patback66/sdvx/README.md

# sdvx
DIY Sound Voltex style controller
