patback66/sdvx/docs/index.md

---
layout: default
---

# Welcome

Welcome to the Custom Arcade Controller tutorial! This tutorial is intended for the construction
of a controller for [Sound Voltex](https://en.wikipedia.org/wiki/Sound_Voltex), but the
fundamentals will be applicable for any custom arcade controller.

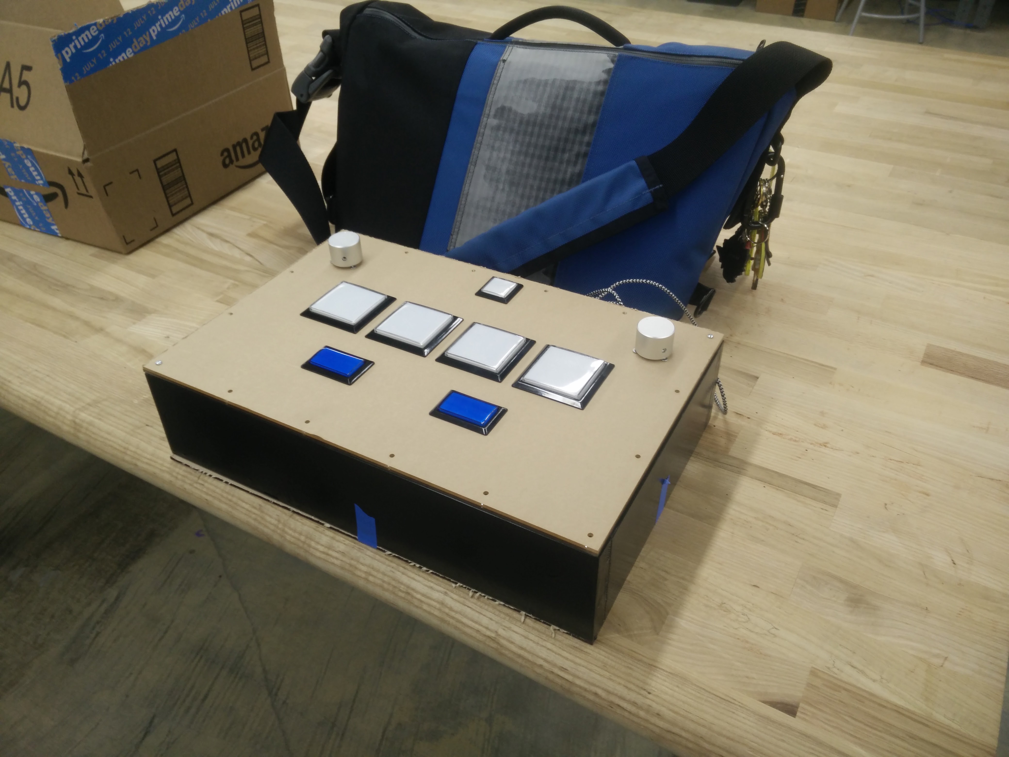
[picture p5: docs/assets/img/IMG_20160810_204727.jpg]
Sample Controller


## Sound Voltex

[Sound Voltex](https://en.wikipedia.org/wiki/Sound_Voltex) is a rhytmn game with
a unique controller. For home play, it may be difficult or expensive to acquire a
controller. For the more technically inclined, building a custom controller may
controller may be the best option.

## Where to Start

The three main sections of this website are:

- [Design](design/) - coming up with what the controller will look like
- [Manufacturing](manufacturing/) - how to build the controller
- [Programming](programming/) - how to program and wire the controller

[comment]: <> (128 Words)
[comment]: <> (Total Word Count: ~5139)
