patback66/sdvx/docs/_pages/references.md

---
layout: page
title: The Plates
permalink: /references/
subtitle: Cutting the Plates
---
1. Aquino, Royce. "SDVX Controller Log 1 | SunKoiWish." Sunkoiwish. May 6, 2016. Accessed October 19, 2016. [http://sunkoiwish.com/story/55-projects/200-sdvx-controller-log-1](http://sunkoiwish.com/story/55-projects/200-sdvx-controller-log-1).
2. Chao, Jess. "Day Wot - The Thought Bubble." SDVX Controller. October 6, 2014. Accessed October 19, 2016. [https://sdvxcontroller.blogspot.com/2014/10/day-wot-thought-bubble.html](https://sdvxcontroller.blogspot.com/2014/10/day-wot-thought-bubble.html).
3. Chao, Jess. "Day Chuu - The Shopping List." SDVX Controller. October 6, 2014. Accessed October 19, 2016. [ https://sdvxcontroller.blogspot.com/2014/10/day-chuu-shopping-list.htm](https://sdvxcontroller.blogspot.com/2014/10/day-chuu-shopping-list.html).
4. Mon. "$70 SDVX Controller." Just Mon Things. July 22, 2016. Accessed October 19, 2016. [http://blog.mon.im/2016/07/70-sdvx-controller.html](http://blog.mon.im/2016/07/70-sdvx-controller.html).
5. Pasquale Buonocunto, Alessandro Biondi, Marco Pagani, Mauro Marinoni, and Giorgio Buttazzo. 2016. “ARTE: arduino real-time extension for programming multitasking applications.” In 	Proceedings of the 31st Annual ACM Symposium on Applied Computing (SAC '16). ACM, New York, NY, USA, 1724-1731.
6. "SDVX Leonardo Tutorial." March 15, 2016. Accessed October 19, 2016. [http://sdvxii.pancakeapps.com/](http://sdvxii.pancakeapps.com/).
7. Sergio Sáez, Jorge Real, and Alfons Crespo. 2012. “An integrated framework for multiprocessor, multimoded real-time applications.” In Proceedings of the 17th Ada-Europe international conference on Reliable Software Technologies (Ada-Europe'12), Mats Brorsson and Luís 	Miguel Pinho (Eds.). Springer-Verlag, Berlin, Heidelberg, 18-34.
