patback66/sdvx/cad/OldVersions/sdvx_top.pdf

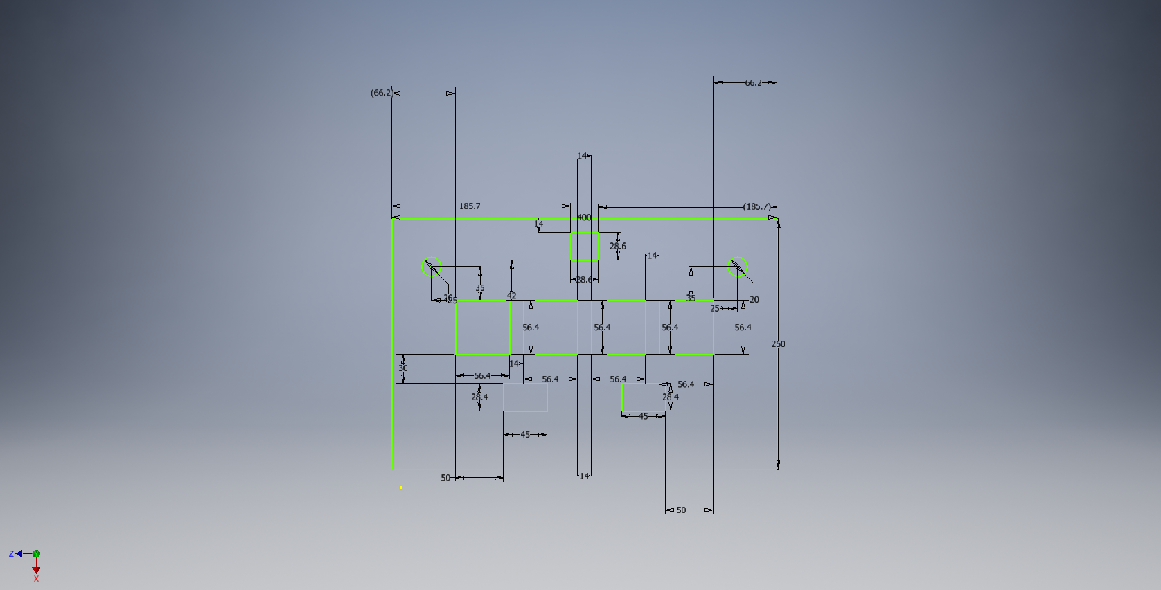
[picture p13: page 1]
