patback66/sdvx/docs/assets/img/10 1 16 11 44 Office Lens.jpg

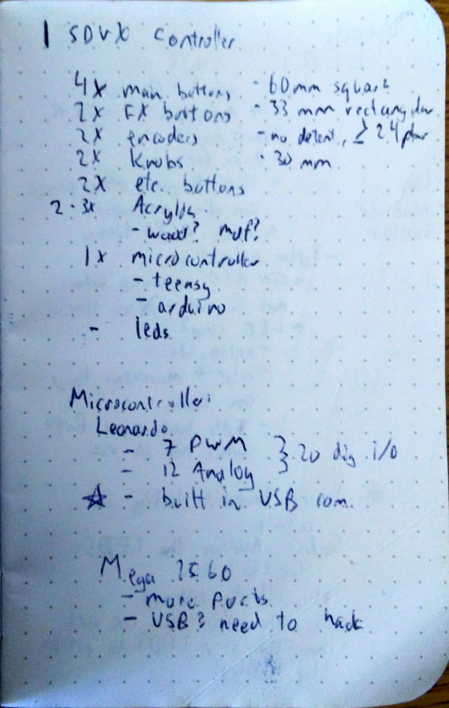
docs/assets/img/10 1 16 11 44 Office Lens.jpg
