patback66/sdvx/docs/assets/img/10 1 16 11 45 Office Lens 1.jpg

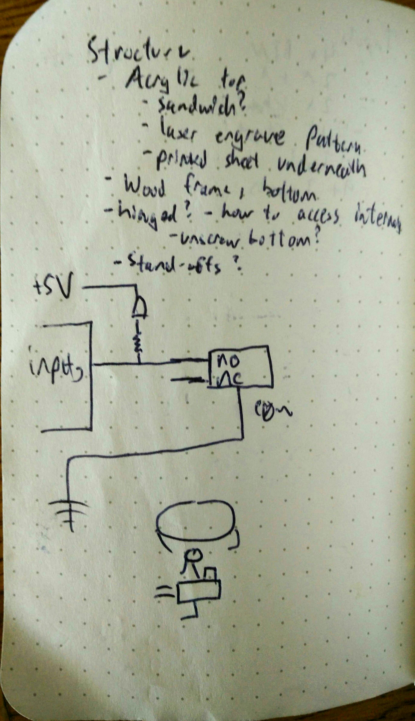
docs/assets/img/10 1 16 11 45 Office Lens 1.jpg
