patback66/sdvx/docs/assets/img/IMG_20160803_185213.jpg

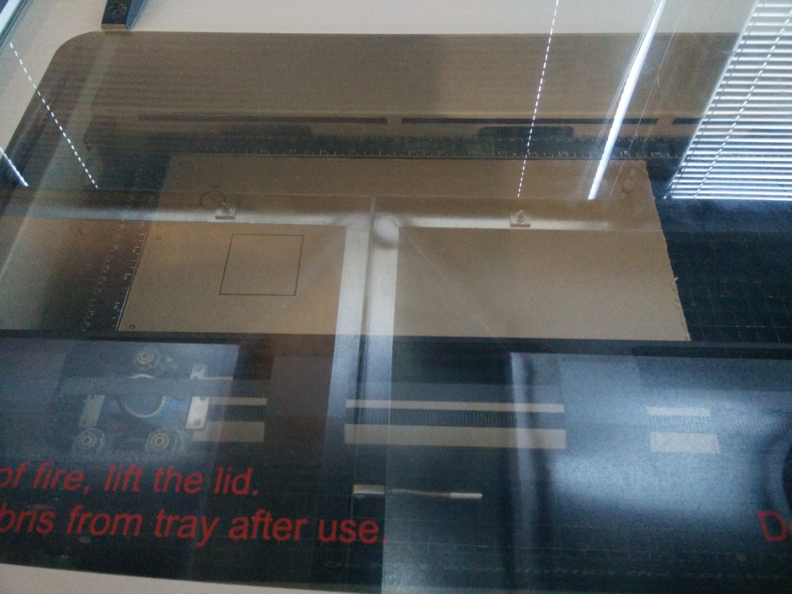
docs/assets/img/IMG_20160803_185213.jpg
