patback66/sdvx/docs/assets/img/IMG_20160803_185450.jpg

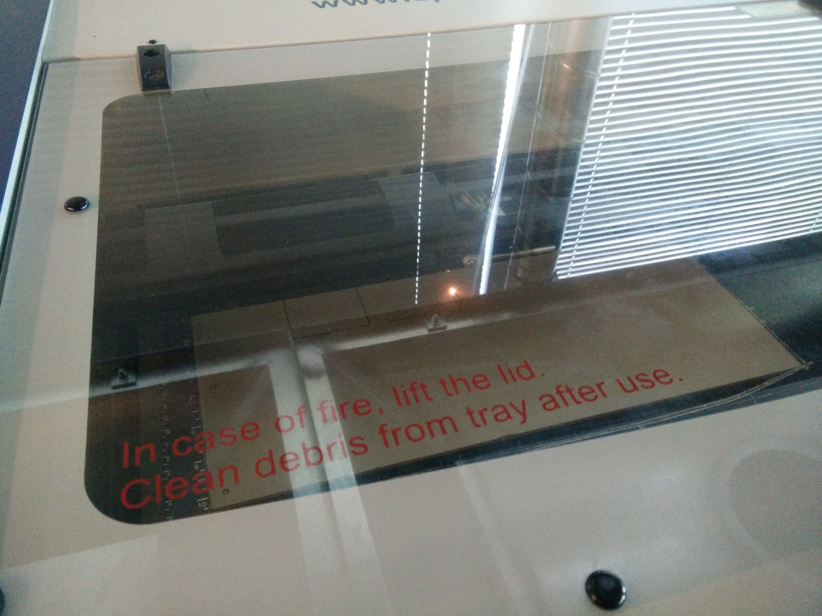
docs/assets/img/IMG_20160803_185450.jpg
