patback66/sdvx/(list of files, cad)

Other CAD files:
cad/sdvx_bottom_check.dwg
cad/sdvx_middle.dwg
cad/sdvx_top_check.dwg
cad/sdvx_bottom.dwg
cad/sdvx_top.dwg
cad/sdvx_middle_check.dwg
cad/OldVersions/sdvx_middle.0001.dwg
cad/OldVersions/sdvx_bottom.0001.ipt
cad/OldVersions/sdvx_middle.0001.ipt
cad/OldVersions/sdvx_top.0005.ipt
cad/sdvx_bottom.ipt
cad/sdvx_middle.ipt
cad/sdvx_top.ipt
