patback66/sdvx/(commit log)

2016-11-05 Switched to jekyll with jackal template
2016-11-18 more wip updates to landing page
